DrLexus83/WaterMetersAndStop/Device_variant.jpg

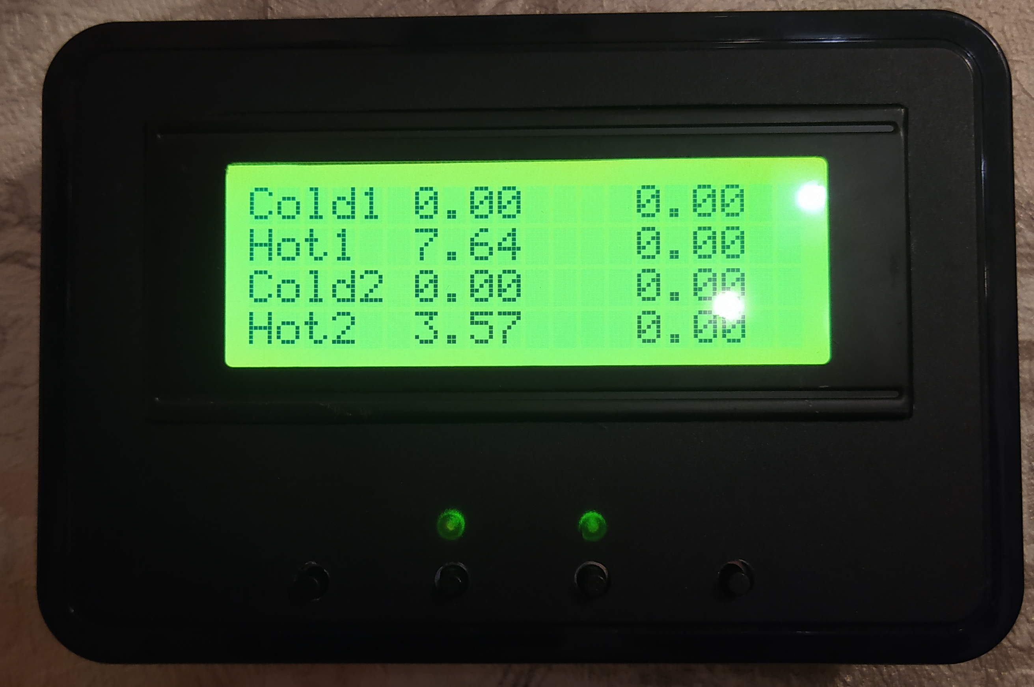
Device_variant.jpg
