DrLexus83/WaterMetersAndStop/Schemes/Подключение крана к реле.jpg

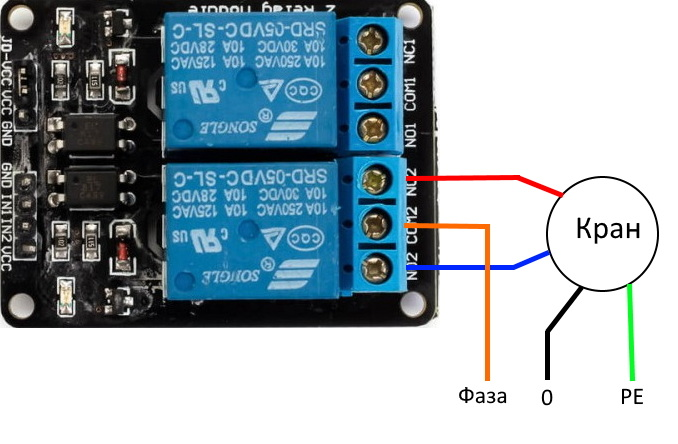
Schemes/Подключение крана к реле.jpg
