DrLexus83/WaterMetersAndStop/Schemes/Схема.jpg

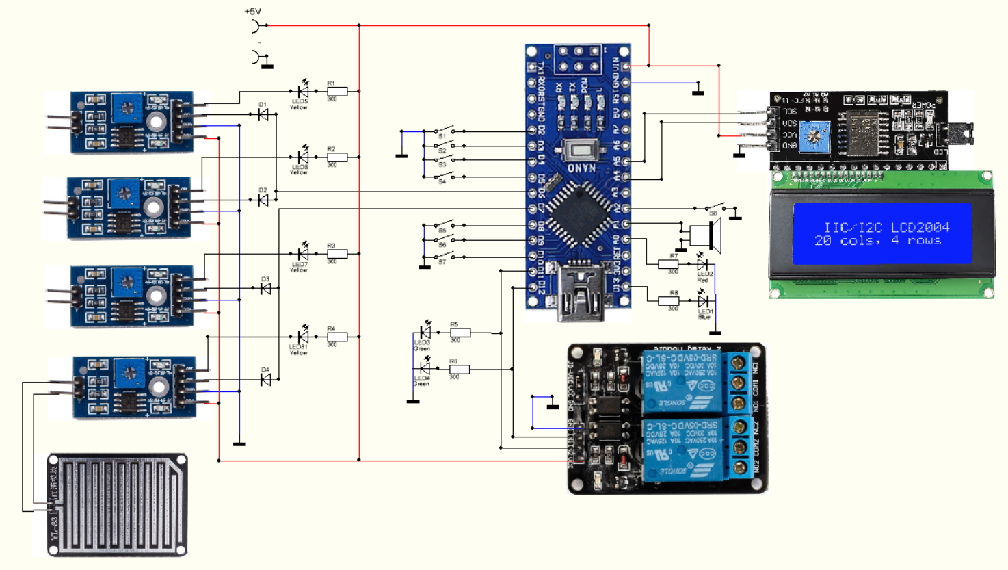
Schemes/Схема.jpg
