DrLexus83/WaterMetersAndStop/History.txt

2.0 Изменен алгоритм работы с показаниями счетчиков - данные теперь хранятся в двумерном массиве, что позволило убрать большинство повторяющихся участков кода и множество глобальных переменных, тем самым сократив скетч. Версия совместима с первоначальными - все данные хранятся по тем же адресам в EEPROM.
1.1 Изменен способ вывода данных на дисплей.
1.0 Исходная версия.
